iandouglas96/swarm-thesis/RobotModel/oneandquarterstandoff.STEP

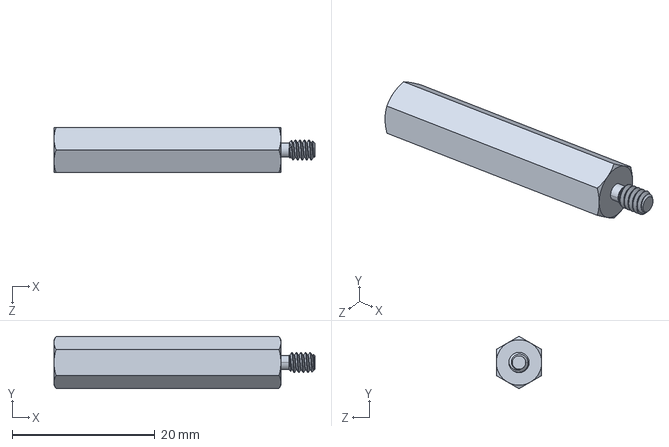
[picture p1: CAD file, 2017-06-16]
RobotModel/oneandquarterstandoff.STEP
36.5 x 7.33 x 6.35 mm
