iandouglas96/swarm-thesis/(list of files, cad)

Other CAD files:
RobotModel/laser_outlines.dwg
RobotModel/OldVersions/laser_outlines.0001.dwg
RobotModel/1_5V_holder4AA.iam
RobotModel/1_5V_holder4AA.ipt
RobotModel/1_5V_holder4AA_1.ipt
RobotModel/1_5V_holder4AA_2.ipt
RobotModel/1_5V_holder4AA_3.ipt
RobotModel/1_5V_holder4AA_4.ipt
RobotModel/NEMA11.ipt
RobotModel/OldVersions/1_5V_holder4AA.0001.iam
RobotModel/OldVersions/base_plate.0004.ipt
RobotModel/OldVersions/base_plate.0007.ipt
RobotModel/OldVersions/halfincaster.0001.ipt
RobotModel/OldVersions/led_brace.0002.ipt
RobotModel/OldVersions/pcb.0006.ipt
RobotModel/OldVersions/robot.0016.iam
RobotModel/OldVersions/side_plate.0003.ipt
RobotModel/OldVersions/side_plate_bottom.0001.ipt
RobotModel/OldVersions/side_plate_top.0001.ipt
RobotModel/OldVersions/top_plate.0007.ipt
RobotModel/Pololu 60mm Wheel.ipt
RobotModel/SG92R.ipt
RobotModel/StationModel/OldVersions/back.0001.ipt
RobotModel/StationModel/OldVersions/side.0002.ipt
RobotModel/StationModel/OldVersions/top.0002.ipt
RobotModel/StationModel/back.ipt
RobotModel/StationModel/side.ipt
RobotModel/StationModel/station.iam
RobotModel/StationModel/top.ipt
RobotModel/base_plate.ipt
RobotModel/halfincaster.ipt
RobotModel/led_brace.ipt
RobotModel/oneandquarterstandoff.ipt
RobotModel/pcb.ipt
RobotModel/quarterin_spacer.ipt
RobotModel/robot.iam
RobotModel/side_plate_bottom.ipt
RobotModel/side_plate_top.ipt
RobotModel/top_plate.ipt
RobotModel/wheel.ipt
