iandouglas96/swarm-thesis/ImageTracking/test_marker.jpg

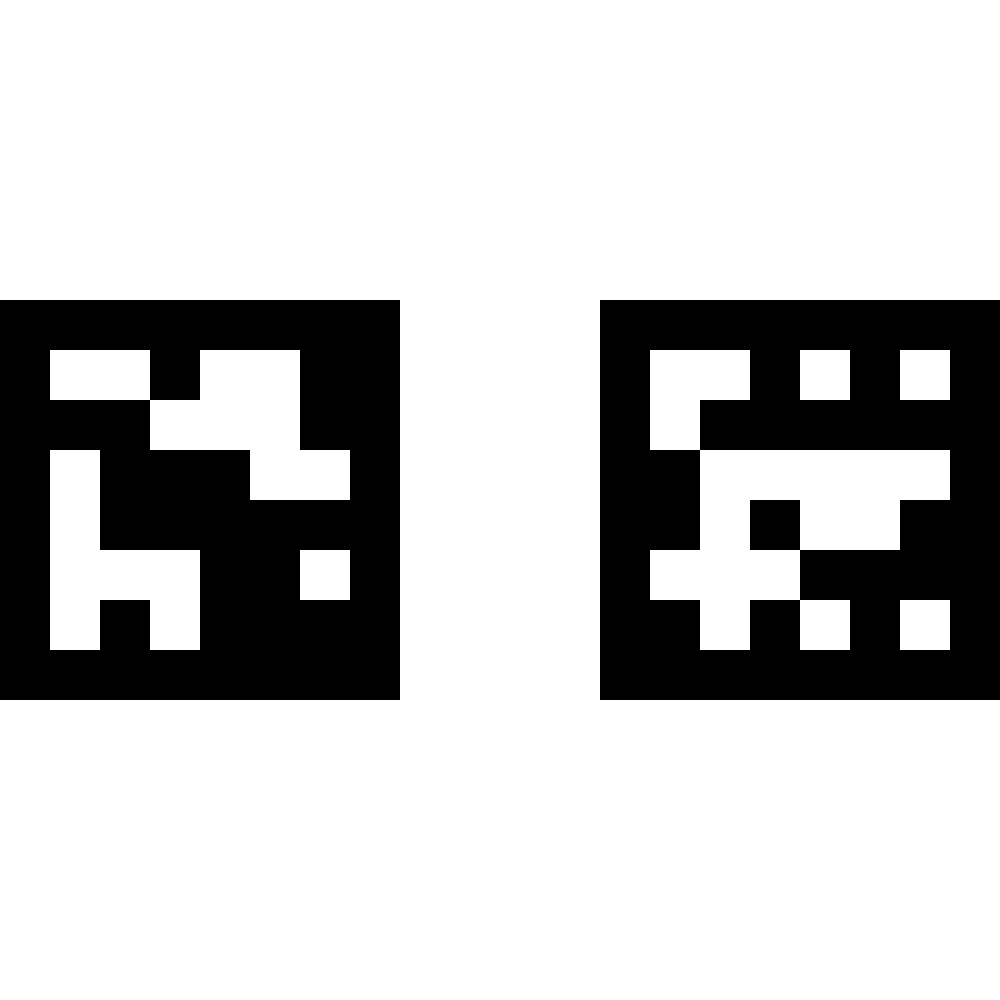
ImageTracking/test_marker.jpg
