iandouglas96/swarm-thesis/test_marker.jpg

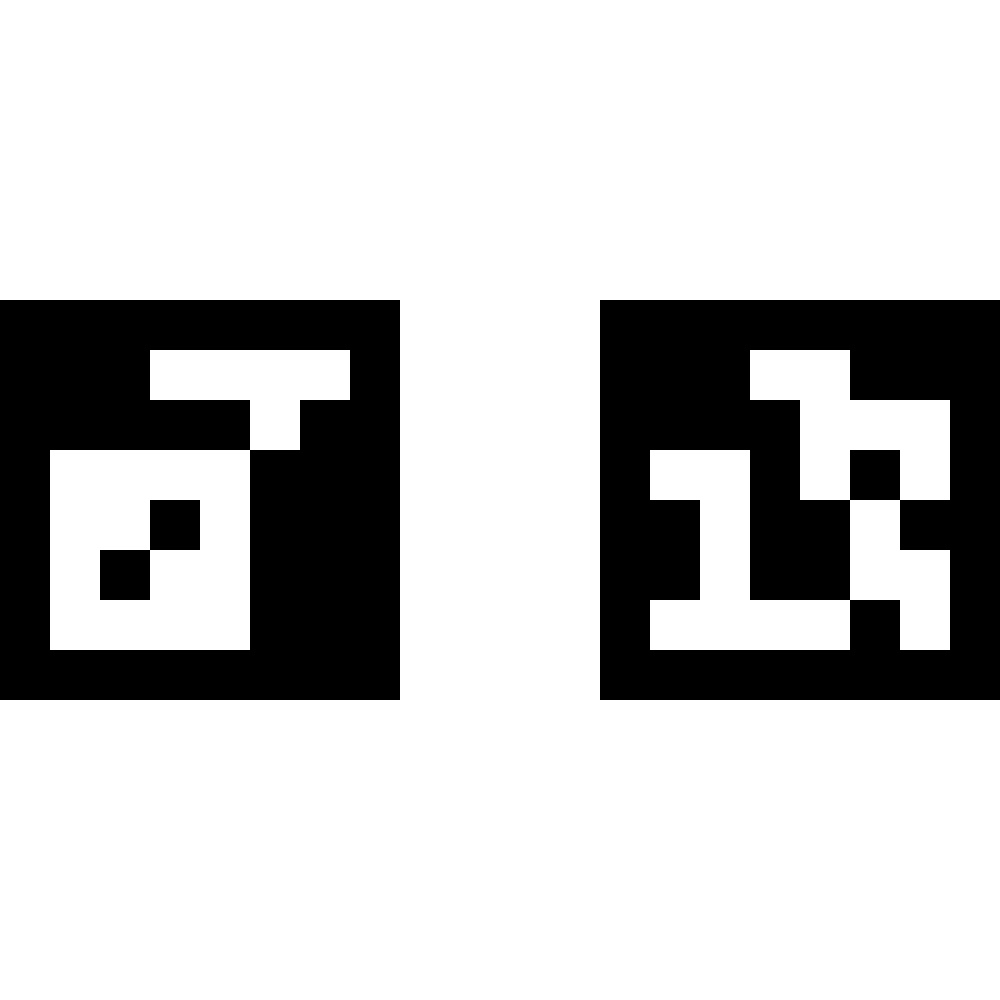
test_marker.jpg
