iandouglas96/swarm-thesis/RobotModel/laser_outlines.pdf

2
2

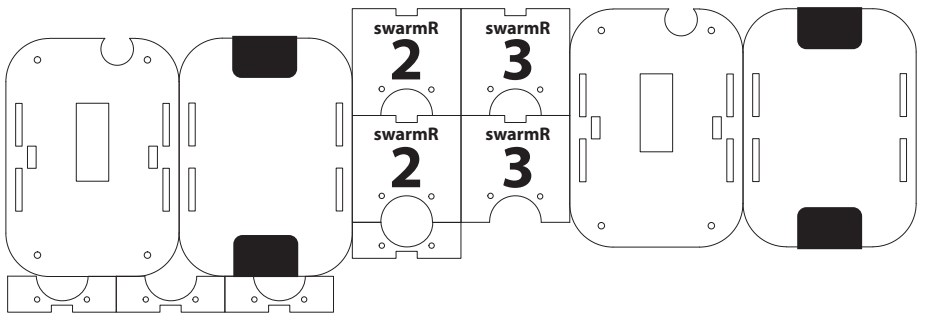
[picture p4: page 1]
swarmR
