iandouglas96/swarm-thesis/PCB/sensor_pcb/sensor_pcb.kicad_pcb

## KiCad design PCB/sensor_pcb/sensor_pcb.kicad_pcb (2018-03-29)

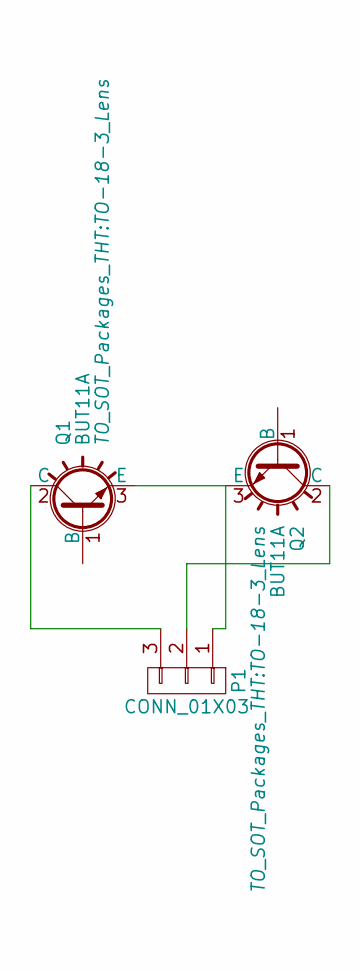
[picture p5: schematic sensor_pcb.sch]

Parts:
P1: CONN_01X03; Pin_Header_Angled_1x03_Pitch2.54mm
Q1, Q2: BUT11A; TO-18-3_Lens

Connections:
unnamed: P1.1, Q1.3 (E), Q2.3 (E)
unnamed: P1.2, Q2.2 (C)
unnamed: P1.3, Q1.2 (C)

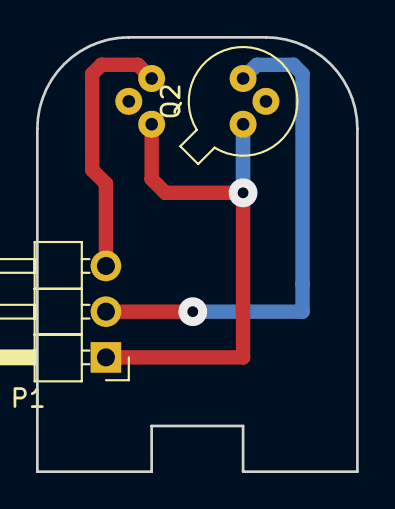
[picture p6: board sensor_pcb.kicad_pcb from above]

Board: 2 copper layers, 17.8 x 24.1 mm, 3 parts (1 on the bottom side), 3 nets.
