iandouglas96/swarm-thesis/PCB/main_pcb.kicad_pcb

## KiCad design PCB/main_pcb.kicad_pcb (2018-03-02)

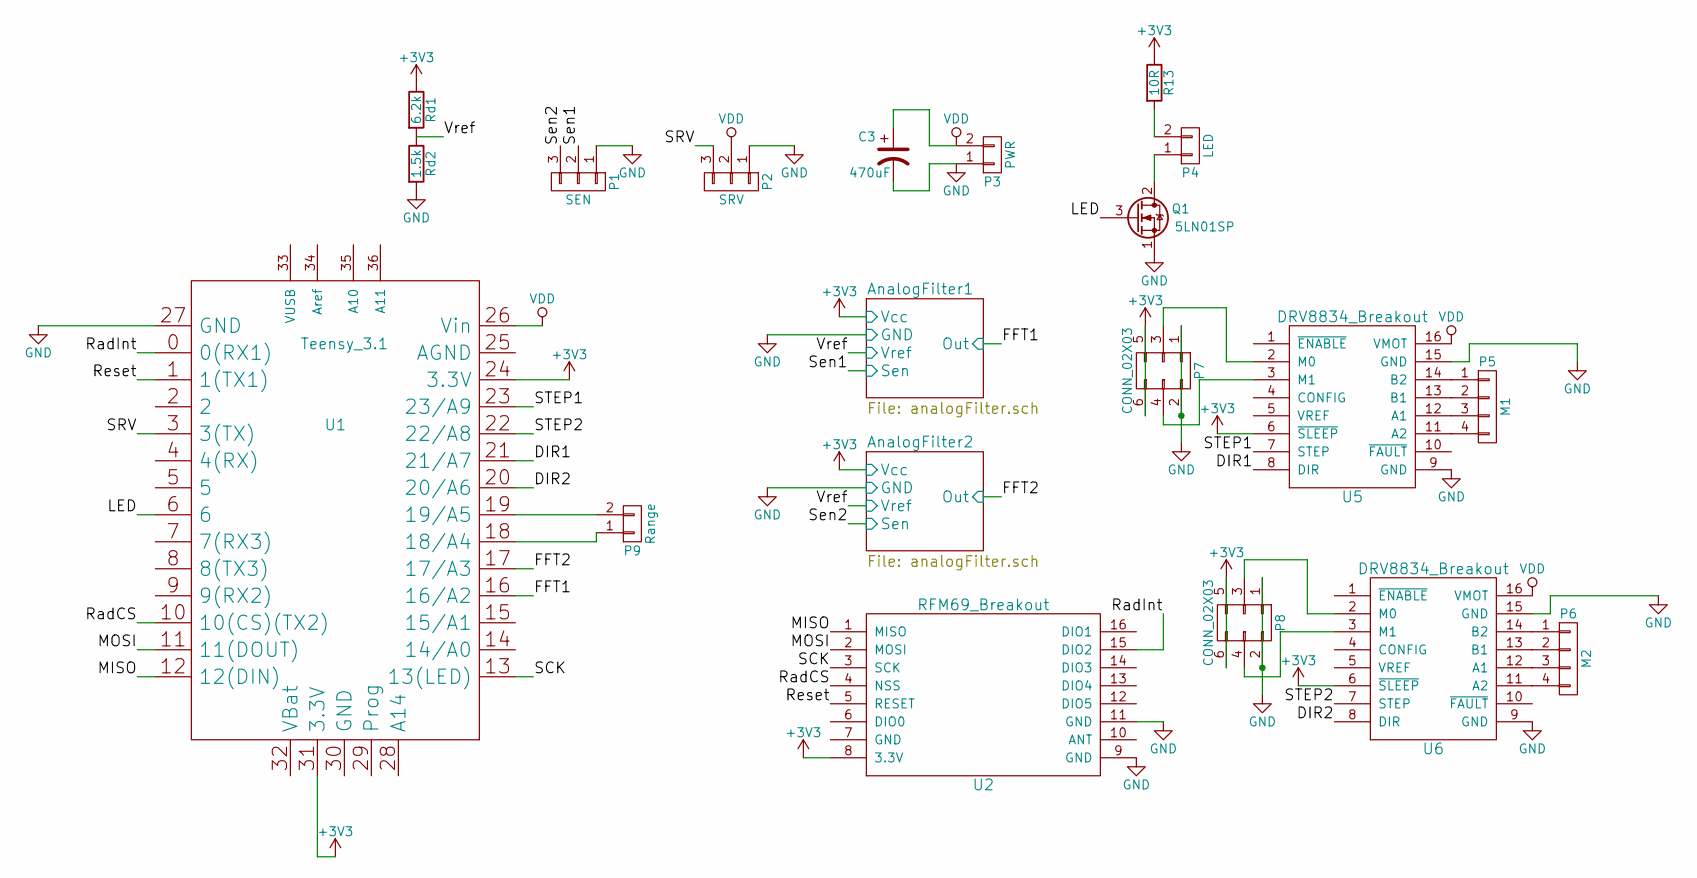
[picture p7: schematic main_pcb.sch]

Parts:
C3: 470uF; CP_Radial_D10.0mm_P5.00mm
P1: SEN; Pin_Header_Straight_1x03_Pitch2.54mm
P2: SRV; Pin_Header_Straight_1x03_Pitch2.54mm
P3: PWR; TerminalBlock_Pheonix_MPT-2.54mm_2pol
P4: LED; Pin_Header_Straight_2x01_Pitch2.54mm
P5: M1; Pin_Header_Straight_1x04_Pitch2.54mm
P6: M2; Pin_Header_Straight_1x04_Pitch2.54mm
P7, P8: CONN_02X03; Pin_Header_Straight_2x03_Pitch2.54mm
P9: Range; Pin_Header_Straight_2x01_Pitch2.54mm
Q1: 5LN01SP; TO-92_Inline_Wide
R13: 10R; R_Axial_DIN0207_L6.3mm_D2.5mm_P7.62mm_Horizontal
Rd1: 6.2k; R_Axial_DIN0207_L6.3mm_D2.5mm_P7.62mm_Horizontal
Rd2: 1.5k; R_Axial_DIN0207_L6.3mm_D2.5mm_P7.62mm_Horizontal
U1: Teensy_3.1; Teensy-3.1
U2: RFM69_Breakout; RFM69Breakout
U5, U6: DRV8834_Breakout; DRV8834Breakout

Connections:
+3V3: P7.5, P7.6, P8.5, P8.6, R13.1, Rd1.1, U1.24 (3.3V), U1.31 (3.3V), U2.8 (3.3V), U5.6 (~SLEEP), U6.6 (~SLEEP); also elsewhere on the board
/DIR1: U1.21 (21/A7), U5.8 (DIR)
/DIR2: U1.20 (20/A6), U6.8 (DIR)
/FFT1: U1.16 (16/A2); also elsewhere on the board
/FFT2: U1.17 (17/A3); also elsewhere on the board
/LED: Q1.3 (G), U1.6
/MISO: U1.12 (12(DIN)), U2.1 (MISO)
/MOSI: U1.11 (11(DOUT)), U2.2 (MOSI)
/RadCS: U1.10 (10(CS)(TX2)), U2.4 (NSS)
/RadInt: U1.0 (0(RX1)), U2.15 (DIO2)
/Reset: U1.1 (1(TX1)), U2.5 (RESET)
/SCK: U1.13 (13(LED)), U2.3 (SCK)
/SRV: P2.3, U1.3 (3(TX))
/STEP1: U1.23 (23/A9), U5.7 (STEP)
/STEP2: U1.22 (22/A8), U6.7 (STEP)
/Sen1: P1.2; also elsewhere on the board
/Sen2: P1.3; also elsewhere on the board
/Vref: Rd1.2, Rd2.1; also elsewhere on the board
GND: C3.2, P1.1, P2.1, P3.1, P7.1, P7.2, P8.1, P8.2, Q1.1 (S), Rd2.2, U1.27 (GND), U2.9 (GND), U2.11 (GND), U5.9 (GND), U5.15 (GND), U6.9 (GND), U6.15 (GND); also elsewhere on the board
unnamed: P4.1, Q1.2 (D)
unnamed: P4.2, R13.2
unnamed: P5.1, U5.14 (B2)
unnamed: P5.2, U5.13 (B1)
unnamed: P5.3, U5.12 (A1)
unnamed: P5.4, U5.11 (A2)
unnamed: P6.1, U6.14 (B2)
unnamed: P6.2, U6.13 (B1)
unnamed: P6.3, U6.12 (A1)
unnamed: P6.4, U6.11 (A2)
unnamed: P7.3, U5.2 (M0)
unnamed: P7.4, U5.3 (M1)
unnamed: P8.3, U6.2 (M0)
unnamed: P8.4, U6.3 (M1)
unnamed: P9.1, U1.18 (18/A4)
unnamed: P9.2, U1.19 (19/A5)
VDD: C3.1, P2.2, P3.2, U1.26 (Vin), U5.16 (VMOT), U6.16 (VMOT)

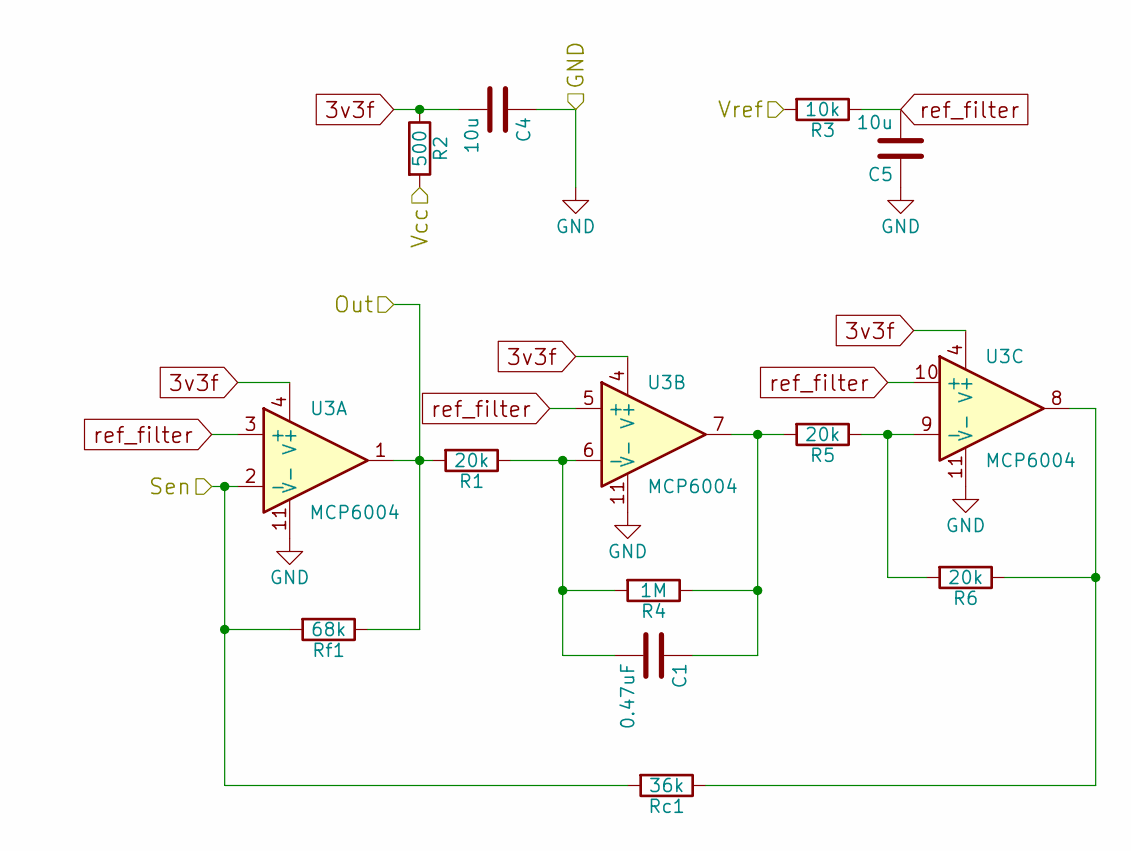
[picture p8: schematic analogFilter.sch]

Parts:
C1: 0.47uF; C_Disc_D4.3mm_W1.9mm_P5.00mm
C4, C5: 10u; C_0805_HandSoldering
R1, R5, R6: 20k; R_Axial_DIN0207_L6.3mm_D2.5mm_P7.62mm_Horizontal
R2: 500; R_0603_HandSoldering
R3: 10k; R_0603_HandSoldering
R4: 1M; R_Axial_DIN0207_L6.3mm_D2.5mm_P7.62mm_Horizontal
Rc1: 36k; R_Axial_DIN0207_L6.3mm_D2.5mm_P7.62mm_Horizontal
Rf1: 68k; R_Axial_DIN0207_L6.3mm_D2.5mm_P7.62mm_Horizontal
U3: MCP6004; DIP-14_W7.62mm_Socket

Connections:
3v3f: C4.2, R2.1, U3.4 (V+); also elsewhere on the board
+3V3: R2.2; also elsewhere on the board
/FFT1: R1.2, Rf1.1, U3.1; also elsewhere on the board
/FFT2: U3.14; also elsewhere on the board
/Sen1: Rc1.2, Rf1.2, U3.2 (-); also elsewhere on the board
/Sen2: U3.13 (-); also elsewhere on the board
/Vref: R3.2; also elsewhere on the board
GND: C4.1, C5.1, U3.11 (V-); also elsewhere on the board
unnamed: C1.1, R4.1, R5.2, U3.7
unnamed: C1.2, R1.1, R4.2, U3.6 (-)
unnamed: R5.1, R6.2, U3.9 (-)
unnamed: R6.1, Rc1.1, U3.8
ref_filter: C5.2, R3.1, U3.3 (+), U3.5 (+), U3.10 (+), U3.12 (+); also elsewhere on the board

Parts of its further copies:
C2: 0.47uF; C_Disc_D4.3mm_W1.9mm_P5.00mm
C6, C7: 10u; C_0805_HandSoldering
R7, R11, R12: 20k; R_Axial_DIN0207_L6.3mm_D2.5mm_P7.62mm_Horizontal
R8: 500; R_0603_HandSoldering
R9: 10k; R_0603_HandSoldering
R10: 1M; R_Axial_DIN0207_L6.3mm_D2.5mm_P7.62mm_Horizontal
Rc2: 36k; R_Axial_DIN0207_L6.3mm_D2.5mm_P7.62mm_Horizontal
Rf2: 68k; R_Axial_DIN0207_L6.3mm_D2.5mm_P7.62mm_Horizontal
U4: MCP6004; DIP-14_W7.62mm_Socket

Connections of its further copies:
3v3f: C6.2, R8.1, U4.4 (V+); also elsewhere on the board
+3V3: R8.2; also elsewhere on the board
/FFT2: R7.2, Rf2.1; also elsewhere on the board
/Sen2: Rc2.2, Rf2.2; also elsewhere on the board
/Vref: R9.2; also elsewhere on the board
GND: C6.1, C7.1, U4.11 (V-); also elsewhere on the board
unnamed: C2.1, R10.1, R11.2, U4.1
unnamed: C2.2, R7.1, R10.2, U4.2 (-)
unnamed: R11.1, R12.2, U4.6 (-)
unnamed: R12.1, Rc2.1, U4.7
ref_filter: C7.2, R9.1, U4.3 (+), U4.5 (+); also elsewhere on the board

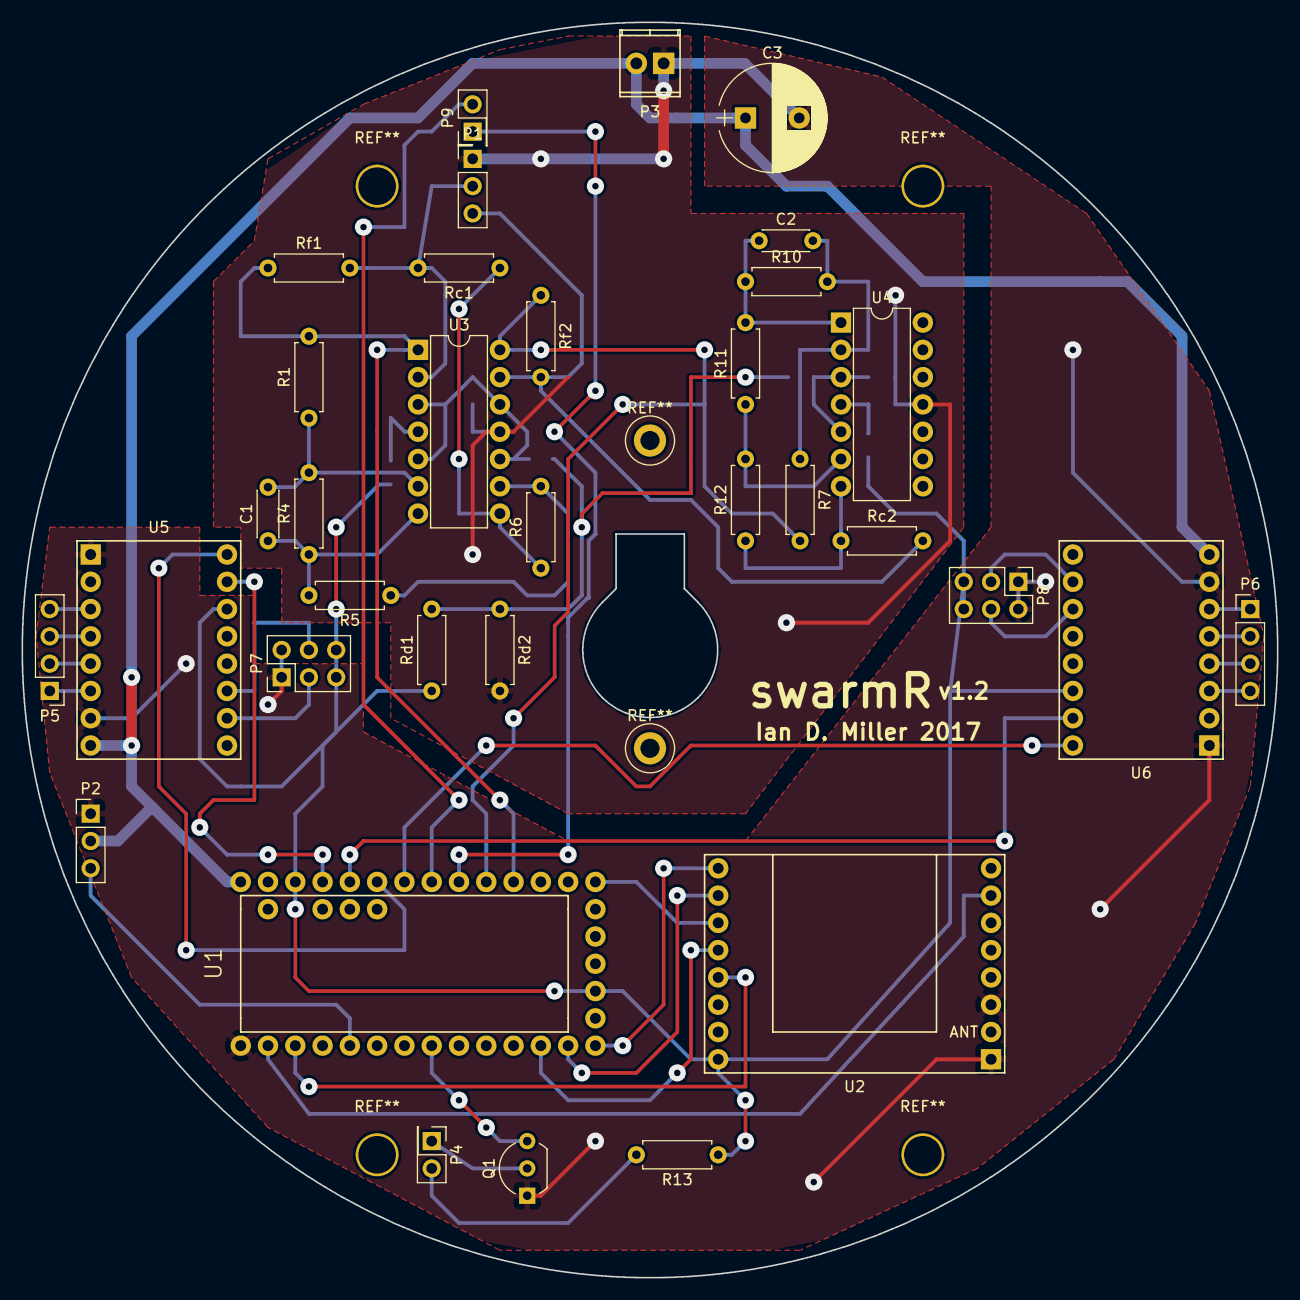
[picture p9: board main_pcb.kicad_pcb from above]

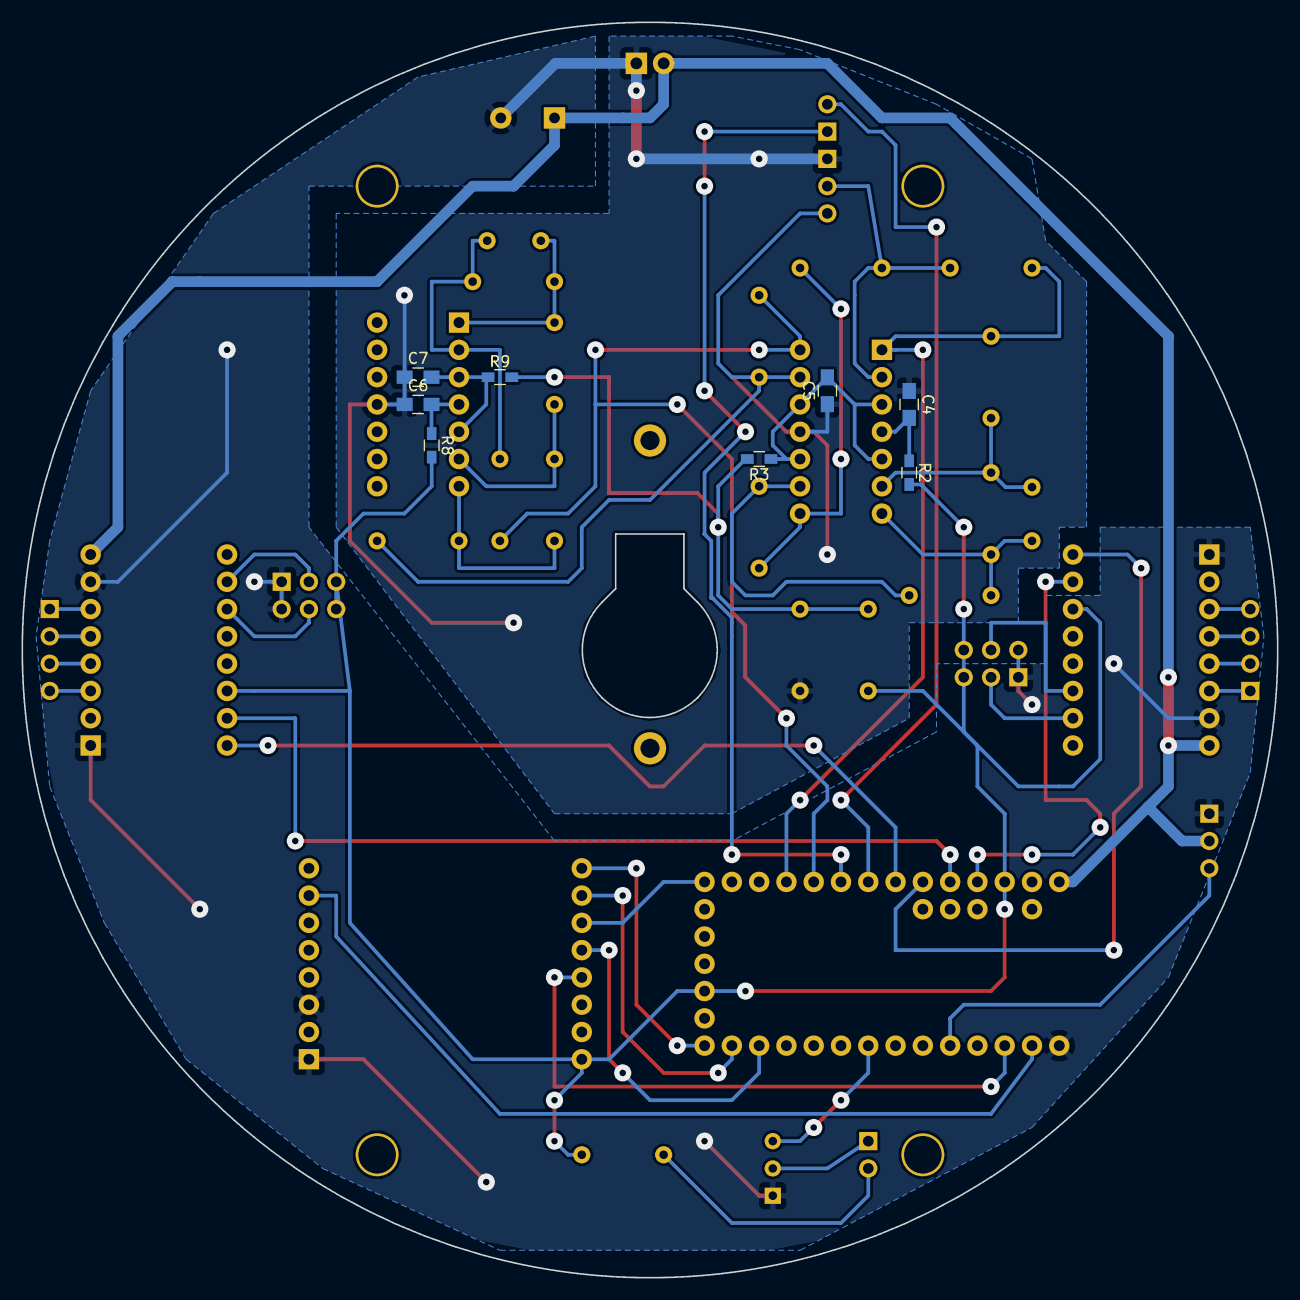
[picture p10: board main_pcb.kicad_pcb from below]

Board: 2 copper layers, 116.9 x 116.9 mm, 42 parts (8 on the bottom side), 46 nets.
