iandouglas96/swarm-thesis/Arduino/swarm/eeprom_structure.h

#ifndef EEPROM_STRUCTURE_H
#define EEPROM_STRUCTURE_H

#define EEPROM_START_ADDRESS 0x00

//struct to be read/written from/to EEPROM
//Put ints at the end for alignment compatibility with Python
typedef struct EEPROM_DATA {
  //Wireless related constants
  unsigned char NodeID;

  //Do we want to send updates to controller?
  uint8_t Verbose;
  
  //Constants relating to swarm behavior
  unsigned int TargetSeparation;
  float AttractionConst;
  float RepulsionConst;

  //Calibration values for sensor
  float SensorCalib1;
  float SensorCalib2;

  //Translation constants for motion
  unsigned int AngularVelocityConst;
  unsigned int LinearVelocityConst;

  //Frequency channel for beacon
  unsigned int Freq;
};

//Checksum in memory immediately after above struct
#define EEPROM_CHECKSUM_ADDRESS sizeof(EEPROM_DATA)  //Checksum
#define EEPROM_CHECKSUM_DEFAULT 0x87654321


//Default values for EEPROM
const EEPROM_DATA EEPROM_DATA_DEFAULT = {
  254,              //NodeID
  
  false,             //Verbose
  
  25,               //TargetSeparation
  1.0,              //AttractionConst
  2.0,              //RepulsionConst

  1.0,           //SensorCalib1
  1.0,           //SensorCalib2
  
  50,               //AngularVelocityConst
  10,               //LinearVelocityConst

  1000              //Freq
};

extern EEPROM_DATA ConstData;

#endif //EEPROM_STRUCTURE_H
