iandouglas96/swarm-thesis/(commit log)

2017-06-15 Added arduino code
2017-06-15 Reorganized Arduino code to point the IDE in the right place
2017-06-15 Added supporting PCB layouts
    [analogFilter.sch, halfincaster.0001.ipt, halfincaster.ipt, main_pcb.kicad_pcb, main_pcb.sch, sensor_pcb.kicad_pcb, sensor_pcb.sch]
2017-06-16 Added simulation code to repo
    [1_5V_holder4AA.ipt, 1_5V_holder4AA_1.ipt, 1_5V_holder4AA_2.ipt, 1_5V_holder4AA_3.ipt, 1_5V_holder4AA_4.ipt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]
2017-06-16 Added code to track both ffts simultaneously
    [oneandquarterstandoff.ipt, robot.0005.iam, robot.0006.iam, robot.iam]
2017-06-16 Incremental: adding motor control
2017-06-19 Added stepper controller to arduino code
2017-06-20 Improved simulation, did most of the pcb trace layout
    [analogFilter.sch, main_pcb.kicad_pcb, main_pcb.sch]
2017-06-20 Improved peak detection algorithm, switched to using op505d part
    [FastCalib.xlsx]
2017-06-21 Pulled in RFM69 library, modified to support teensy
    [_saved_main_pcb.sch, analogFilter.sch, main_pcb.kicad_pcb]
2017-06-21 Finished PCB and robot designs
    [_saved_main_pcb.sch, base_plate.0003.ipt, base_plate.ipt, led_brace.0001.ipt, led_brace.0002.ipt, led_brace.ipt, main_pcb.sch, pcb.0003.ipt]
2017-06-21 Added kerf compensation to inventor models
    [base_plate.0002.ipt, base_plate.0003.ipt, base_plate.0004.ipt, base_plate.0005.ipt, base_plate.ipt, pcb.0005.ipt, pcb.0006.ipt, pcb.ipt]
2017-06-21 Minor adjustments to laser outlines
    [base_plate.0005.ipt, base_plate.0007.ipt, base_plate.ipt, laser_outlines.0001.dwg, laser_outlines.dwg, robot.0009.iam, robot.0011.iam, robot.iam]
2017-06-22 Updated pcb layout for easier fabrication
    [main_pcb.kicad_pcb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]
2017-06-23 minor pcb and BOM adjustments
    [FastCalib.xlsx, analogFilter.sch, main_pcb.kicad_pcb, main_pcb.sch, main_pcb_bom.csv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]
2017-06-26 Small pcb adjustments
    [main_pcb.kicad_pcb, sensor_pcb.kicad_pcb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]
2017-06-28 Added force computation
    [Calib.xlsx, back.0001.ipt, back.ipt, side.0002.ipt, side.ipt, station.iam, top.0002.ipt, top.ipt]
2017-07-03 Added wireless command format proposed doc
    [Calib.xlsx, FastCalib.xlsx]
2017-07-03 Incremental: adding wireless command capabilities. DOES NOT COMPILE
2017-07-04 Functioning wireless communication framework
2017-07-05 Functioning python serial receiving driver
2017-07-05 Switched to transmitting length instead of using null terminator
2017-07-06 Adjustments to arduino code to support manual control
2017-07-07 Incremental: switching to new RFM69 library
2017-07-07 switched to new rfm69 library mostly complete
2017-07-10 Functional update framework
2017-07-10 Arduino side stuff to fix updates
    [swarm.ino, wirelessDriver.ino]
2017-07-11 added calib info
    [calib.csv]
2017-07-12 calibration adjustments
2017-07-12 PCB revisions
    [_saved_main_pcb.sch, main_pcb.kicad_pcb]
2017-07-17 Updated sensor pcb to use nte3037 part
    [_saved_sensor_pcb.sch, main_pcb.kicad_pcb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]
2017-07-17 Recalibrated resistor gains
    [_saved_sensor_pcb.sch, analogFilter.sch, main_pcb.kicad_pcb, sensor_pcb.kicad_pcb, sensor_pcb.sch]
2017-07-17 Sensor pcb redesign. Fixed bug where teensy would freeze if there were more than 10 targets
    [main_pcb_bom.csv, sensor_pcb.kicad_pcb]
2017-07-19 Debugging tweaks
    [beacon_pcb.kicad_pcb, laser_outlines.0001.dwg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]
2017-07-19 debugging tweaks, bug fixes for receiver
    [controller.ino]
2017-07-21 New peak detection algorithm to merge peake too close to eachother
    [main_pcb.kicad_pcb]
2017-07-21 Added tx timeout to transmitter to avoid buffer getting in weird state
    [controller.ino]
2017-07-21 Reworked manual mode, added frequency to eeprom
    [eeprom_structure.h, swarm.ino, wirelessDriver.ino]
2017-07-21 Added copper pours
    [analogFilter.sch, main_pcb.kicad_pcb]
2017-07-24 pcb tweaks
    [main_pcb.kicad_pcb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]
2017-09-05 Refined sim calibration
2017-10-01 Added code for positioning characterization
    [data.csv]
2017-10-02 Added simple location integration to control software
    [data.csv]
2017-10-05 Major performance improvements in numpy code
    [data.csv]
2017-10-19 Working simple EKFKF
    [data.csv]
2017-11-11 Working UKF
    [data.csv]
2017-12-05 Switched to sending distance data over wireless instead of magnitude
2017-12-05 Added sensor calibration to EEPROM on a per-robot basis. Now transmit distance in cm in verbose mode instead of sensor return magnitude
2018-01-22 Fixed bug with ordering of robots when scanning in the minimization state
    [data.csv]
2018-02-02 Added code to generate 4-square aruco board for robots
2018-02-08 In progress integration of motion capture system into control software
    [data.csv]
2018-02-09 Working comparison b/w mcap and sensor system
2018-02-22 Tweaks for logging data to file for later analysis
    [data.csv]
2018-02-23 Fine calibration adjustments
    [data.csv]
2018-03-02 Fixed some motor speed modelling errors
    [analogFilter.sch, main_pcb.kicad_pcb]
2018-03-07 Added comparison with minimization algorithm in real time. Lots of bug fixes in minimization algorithm and kalman filter models having to do with coordinate system problems (particularly signs of ang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
    [data.csv]
2018-03-29 Updated simulator to work with fixed coordinate system in hardware
    [data.csv, main_pcb.csv, main_pcb_bom.csv, sensor_pcb.kicad_pcb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]
2018-03-29 Added framework for timed preset command execution
    [data.csv]
2018-04-04 Added several preset test cases
    [data.csv]
2018-05-01 Check and block data indicating robot seeing itself, which destabilized ukf
    [data.csv]
2018-05-07 Final commit after presentation
    [data.csv]
