iandouglas96/swarm-thesis/(notices)

Notices in the files:
Arduino/Gateway/Gateway.ino:
Copyright Felix Rusu 2016, http://www.LowPowerLab.com/contact
Public License as published by the Free Software
